HydrogreenPollub/stm32-can-converter-unit/(list of files, drawings)

Other design files:
Can Converter Unit - PCB/CCU.PcbDoc
Can Converter Unit - PCB/Main.SchDoc
Can Converter Unit - PCB/mcu.SchDoc
Can Converter Unit - PCB/power.SchDoc
Can Converter Unit - PCB/stm32-can-converter-unit.PrjPcb
Can Converter Unit - PCB/Transcievers.SchDoc
can_converter_unit_v2/can_converter_unit_v2.PrjPcb
can_converter_unit_v2/CCU-2-ICs.SchDoc
can_converter_unit_v2/CCU-2-inputs.SchDoc
