HydrogreenPollub/stm32-can-converter-unit/(commit log)

2025-10-11 Add .SchDoc & .PcbDoc
    [PCB1.PcbDoc, Sheet1.SchDoc, stm32-can-converter-unit.PrjPcb]
2025-10-11 Add 12V buck converter
    [Main.SchDoc, PCB1.PcbDoc, Sheet1.SchDoc, io.SchDoc, mcu.SchDoc, power.SchDoc, stm32-can-converter-unit.PrjPcb]
2025-10-16 Add power connections & mcu
    [Main.SchDoc, mcu.SchDoc, power.SchDoc]
2025-10-16 Add MCU crystals & buttons
    [mcu.SchDoc]
2025-10-16 Add LED connections
    [mcu.SchDoc]
2025-10-16 Add RS485 converter datasheet
    [io.SchDoc]
2025-10-22 Add RS485 & CAN IC's
    [io.SchDoc, mcu.SchDoc]
2025-10-22 Add differential pairs in schematic
    [io.SchDoc, mcu.SchDoc]
2025-10-29 Add RS485 & plugs
    [Main.SchDoc, io.SchDoc, mcu.SchDoc, power.SchDoc]
2025-10-30 Add connections
    [Main.SchDoc, mcu.SchDoc]
2025-11-01 Add sth
    [Main.SchDoc, io.SchDoc, mcu.SchDoc, power.SchDoc, stm32-can-converter-unit.PrjPcb]
2025-11-01 Add sheet IO's
    [Main.SchDoc, io.SchDoc, mcu.SchDoc]
2025-11-04 Finished all electrical connections
    [Main.SchDoc, io.SchDoc, mcu.SchDoc, power.SchDoc]
2025-11-07 Corrected M12 socket
    [Main.SchDoc]
2025-11-19 Add components to physical layer
    [Main.SchDoc, power.SchDoc]
2025-11-19 Add buttons
2025-11-22 Configure pinout
    [Main.SchDoc, mcu.SchDoc]
2025-11-24 Add component placement
    [mcu.SchDoc]
2025-11-25 Add sseedd
    [io.SchDoc, mcu.SchDoc]
2025-11-25 Add WAGO connectors
    [Main.SchDoc]
2025-11-27 Add traces to PCB
    [Main.SchDoc, io.SchDoc, mcu.SchDoc, power.SchDoc]
2025-11-30 Add Power and GND pours
    [PCB1.PcbDoc, stm32-can-converter-unit.PrjPcb]
2025-11-30 Add pours
    [PCB1.PcbDoc]
2025-12-01 Corrected errors
    [PCB1.PcbDoc]
2025-12-01 Add sheet descriptions
    [CCU.PcbDoc, Main.SchDoc, Transcievers.SchDoc, io.SchDoc, mcu.SchDoc, power.SchDoc, stm32-can-converter-unit.PrjPcb]
2025-12-01 Add board name
    [CCU.PcbDoc]
2025-12-01 Add name
    [CCU.PcbDoc, stm32-can-converter-unit.PrjPcb]
2025-12-02 Add logo
    [CCU.PcbDoc]
2025-12-03 Add zener diode
    [CCU.PcbDoc, power.SchDoc]
2025-12-03 Changed m12 socket pinout
    [CCU.PcbDoc, Main.SchDoc, Transcievers.SchDoc, stm32-can-converter-unit.PrjPcb]
2025-12-07 Changed TVS diode footprint & rerouted diff pairs
    [CCU.PcbDoc, Transcievers.SchDoc]
2025-12-07 Add manufacturing files
    [CCU.PcbDoc, stm32-can-converter-unit.PrjPcb]
2025-12-07 Add solder mask expansion rule
    [CCU.PcbDoc, Main.SchDoc]
2026-01-06 Committed to Altium 365
    [stm32-can-converter-unit.PrjPcb]
2026-01-11 Corrected Boot0 pin
    [mcu.SchDoc]
2026-01-11 Fixed path to BOOT0
    [CCU.PcbDoc, mcu.SchDoc]
2026-01-21 Add interactive BOM
2026-01-21 Add assembly html
2026-01-21 Cleaned Repo
    [CCU.PcbDoc, Main.SchDoc, Transcievers.SchDoc, mcu.SchDoc, power.SchDoc, stm32-can-converter-unit.PrjPcb]
2026-05-02 Corrected html file
    [can_converter_unit_v2.PrjPcb]
2026-05-02 Add CCU v2 project
    [CCU-2-ICs.SchDoc, CCU-2-inputs.SchDoc, CCU.PcbDoc, can_converter_unit_v2.PrjPcb]
